laurencebarker/SaturnG2V2_Front_Panel/README.md

# SaturnG2V2_Front_Panel
 V2 andromeda-like panel for G2
