laurencebarker/SaturnG2V2_Front_Panel/documentation/G2 mk2 front panel Notes.docx

# G2 Mk2 Front Panel Implementation Notes

This documentation is for the G2 mk2 front panel PCB using the Arduino Nano Every processor and 2 MCP23S17 ICs. It has I2C interface to the Raspberry Pi.

# 1 Control Layout

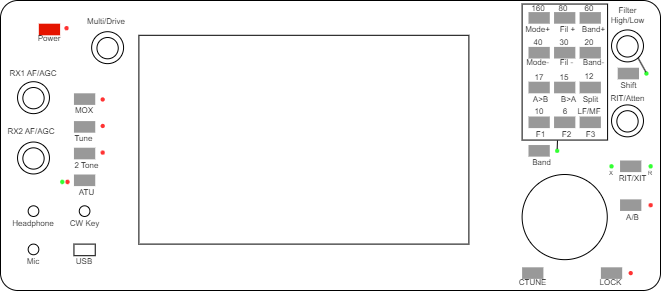
[picture p1: figure]

## 1.1 Encoder Numbers

The VFO encoder is treated differently from the dual encoders because its inputs are processed differently. From a software perspective, each dual encoder can have A (upper) and B (lower) encoders plus a “click” function. The “click” is treated as a pushbutton by the Arduino.

The top right encoder will be able to have two functions, using a “Shift” button. The Shift functionality is implemented in the Arduino, and the Raspberry Pi will see 6 dual connected encoders.

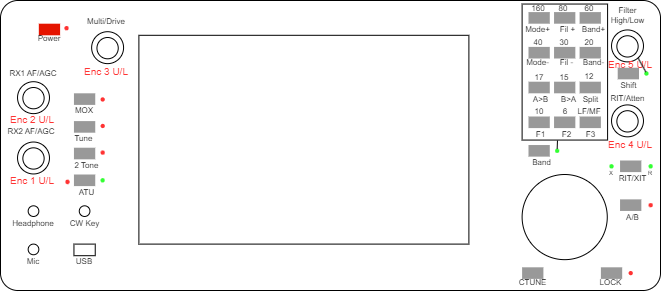
[picture p2: figure]

Figure 1: Encoder numbers

Normal dual shaft encoders have encoder numbers as follows:

Encoder | Software Scan Code
| Upper knob | Lower knob
1 | 0 | 1
2 | 2 | 3
3 | 4 | 5
4 | 6 | 7
5 | 8 | 9
6 (encoder 5 when shift is active) | 10 | 11

(CAT message identify the encoder numbers as scan code + 1)

## 1.2 Pushbutton Numbers

Pushbuttons have two numbers: the software scan code from the matrix algorithm; and the number that is reported to the Raspberry pi. A lookup table from scan code gives the reporting number. The scan codes are only used by the Arduino software and have no user meaning.

Band buttons in the 3x4 matrix have two functions according to the BAND shift. The band shift functionality is implemented in the Arduino; the effect is that the user software “sees” additional pushbuttons for band and unshifted function. If shift pressed, a button code 13 higher is given for example "Fil -" will give a code of 18 (no shift) or 31 (band function shifted). The shift buttons themselves do not send codes to the Raspberry Pi. PB13 (encoder 5 pushbutton) will generate a code of 26 if the encoder shift is selected. If encoder shift is active, the button for encoder 5 will generate a different code of 41.

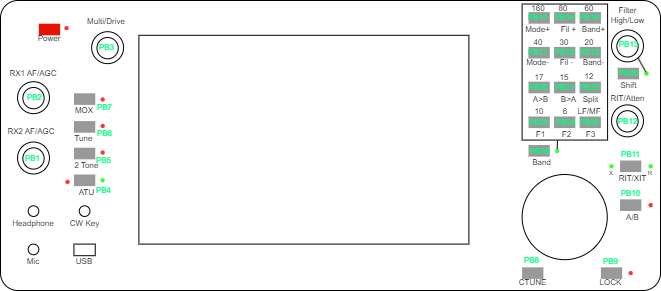
[picture p3: figure]

Figure 2: Software Scan Codes

A complete list of reported button codes is below.

Button Function | Code | Button Function | Code | Button Function | Code | Button Function | Code
No button | 0 | RIT/XIT | 11 | Split | 22 | 17M | 33
Encoder 1 press | 1 | Encoder 4 press | 12 | User 1 | 23 | 15M | 34
Encoder 2 press | 2 | Encoder 5 press | 13 | User 2 | 24 | 12M | 35
Encoder 3 press | 3 | Mode + | 14 | User 3 | 25 | 10M | 36
ATU | 4 | Filter + | 15 | No button | 26 | 6M | 37
2 Tone | 5 | Band + | 16 | 160M | 27 | LF/MF | 38
Tune | 6 | Mode - | 17 | 80M | 28 | Band shift* | 39
MOX | 7 | Filter - | 18 | 60M | 29 | Encoder shift* | 40
CTUNE | 8 | Band - | 19 | 40M | 30 | Shifted Encoder 6 press | 41
LOCK | 9 | A>B | 20 | 30M | 31
A/B | 10 | B>A | 21 | 20M | 32

Band and encoder shift codes are only generated if a command has been sent to disable normal shift processing. This is appropriate for Thetis but not for piHPSDR.

## 1.3 Indicator Numbers

Note LED10, 11 are not accessible to client s/w. Their functions are controlled by the Arduino, unless shift functionality has been disabled by a command.

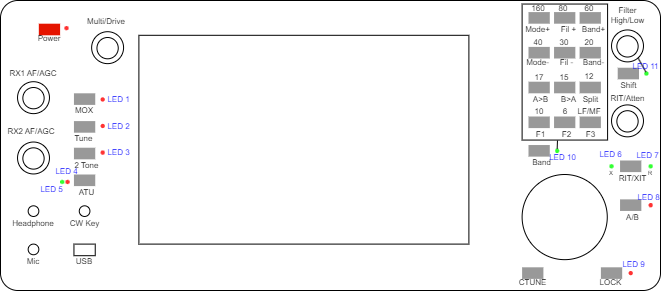
[picture p4: figure]

Figure 3: Indicator Numbers

# 2 Arduino Software Structure

An 8 bit Arduino Nano Every will be used, with software substantially based on the Andromeda panel code.

## 2.1 Concept for Operation

The Arduino will interface the I/O devices, consisting of optical VFO encoder, mechanical dual shaft encoders, pushbuttons and LEDs. It will handle all debouncing and present completed event data to the Raspberry pi. Events will be stored in a simple circular buffer queue and transferred at a timestep of every few milliseconds (potentially every 10ms) to avoid signalling and data transfer becoming a drain on processor resources.

Events will consist of:

- VFO encoder steps (potentially up to 20 steps per 10ms timestep);
- Mechanical encoder steps;
- Pushbutton events.

In addition the Arduino will receive commands at similar rate via serial to set front panel LEDs.

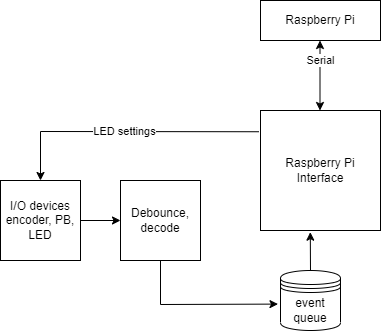
[picture p5: figure]

Figure 4: Software Structure

The VFO encoder may generate 500 steps per revolution and can be turned at 4 revolutions per second; so several steps per timestep are possible. VFO encoders generate clean edges, and interrupt driven operation is viable.

Mechanical encoders generate noisy edges and will be polled, with a debounce period of around 5 - 10ms after detection of a transition. A high turn rate would be one revolution per second and typically 24 steps so typically a rate of 40ms per step. One step per event is sufficient. All encoders will be scanned in parallel, but it is unlikely that more than one will be turned at a time so a high event rate is unlikely.

Pushbutton encoders also generate noisy edges and will be polled. The pushbuttons will be scanned in a matrix, allowing only one button press at a time. A debounce period of ~10ms is required and the event rate will be a max of say two presses per second. Both “normal” and “long” presses will be decoded.

Two “special” pushbuttons will provide a shift function. These will provide additional functions for 12 pushbuttons, and for one dual encoder. This will be decoded by the Arduino and the Raspberry pi will see an interface as if an additional 12 buttons and one additional dual encoder are present. (These two buttons and their LEDs can also be set to operate like other pushbuttons by command message from the Raspberry pi).

## 2.2 Use of Timeslots

Like all of my Arduino projects, the code will work to a fixed timer driven timestep. It will not follow the normal Arduino practice of executing a loop continuously; it will only run a loop once per timestep. That allows real time operation with known event timings.

Follow the principle from the Andromeda front panel controller: 2ms timestep is the starting point.

In one timeslot we need to:

- Do one update of the key matrix (involves SPI read, then SPI write);
- Update half of the encoders; (SPI 16 bit read);
- Update any LEDs;
- Add any events to event queue and assert interrupt if it is not empty;
- Drive new switch matrix column in advance of next tick.

## 2.3 SPI ports

SPI connects to two MCP23S17 devices. Each has an active low chip select input, to be driven by the Arduino. There is no interaction or dependency with the Raspberry Pi interface.

SPI needs to support the following operations:

1. 8 bit register write, for configuration & for LED / matrix column write
2. 16 bit read from adjacent registers (encoder data read)
3. 8 bit read from one register (switch matrix row read)

## 2.4 Data Exchange with Raspberry Pi

Serial message exchanges needed for:

1. Set indicators (ZZZI exists for this)
2. Read product ID, hardware ID, software version (ZZZS)
3. Read VFO encoder steps (ZZZU, ZZZD)
4. Read dual encoder events (ZZZE)
5. Read pushbutton events (ZZZP)

## 2.5 CAT Messages

This unit uses the same CAT commands as used for Andromeda. That means the existing THETIS / piHPSDR CAT command set can be used.

Control type | Command | Meaning
VFO encoder | Up: ZZZUnn; Down: ZZZDnn; | nn = number of clicks (0-99)
Other encoder | ZZZEnnm; | nn = encoder number: 0: unused 1-20: encoder 1-20, clockwise 51-70: encoder 1-20, anticlockwise m=number of clicks (0-9)
Pushbutton (including encoder) | ZZZPnnm; | nn=button number (1-99, 0=n/a); m=0: released; m=1: pressed; m=2: long pressed
Indicator | ZZZInnm; | nn=indicator number (1-99, 0=n/a); m=0: unlit; m=1: lit
Send s/w Version | ZZZS; Response ZZZSppnnmmm; | pp=product id 1: Andromeda 2: Aries 3: Ganymede 4: G2 panel; 5: G2V2 panel nn= hardware version mmm= s/w version

## 2.6 Scan codes

Button, indicator numbers are as indicated in the pictures at the start of the document. They are listed here together with suggested functions for client SDR applications.

### 2.6.1 Encoder

Physical control | s/w code for CAT message | Suggested function
1, upper | 1 | RX2 AF Gain
1, lower | 2 | RX2 AGC
2, upper | 3 | RX1 AF Gain
2, lower | 4 | RX1 AGC
3, upper | 5 | Multifunction encoder
3, lower | 6 | TX drive
4, upper | 7 | RIT/XIT
4, lower | 8 | Attenuation
5, upper (no shift) | 9 | RX filter high cut
5, lower (no shift) | 10 | RX filter low cut
5, upper (SHIFT lit) | 11 | Diversity gain
5, lower (SHIFT lit) | 12 | Diversity phase

### 2.6.2 Pushbutton

Scan code | Marking | Suggested function (normal) | Suggested function (long press)
1 | Encoder 1 press | RX2 Mute
2 | Encoder 2 press | RX1 Mute
3 | Encoder 3 press | Change multifunction assignment
4 | ATU | Not yet used – TBD
5 | 2 Tone | Toggle 2 tone test
6 | Tune | Toggle TUNE
7 | MOX | Toggle MOX
8 | CTUNE | Toggle CTUNE
9 | LOCK | Toggle VFO lock
10 | A/B | Set whether other buttons affect VFO A or VFO B. If not yet pressed, A
11 | RIT/XIT | Toggle between off/RIT/XIT
12 | Encoder 4 press | Clear RIT and XIT
13 | Encoder 5 press (no shift) | Reset variable filter 1
14 | Mode + | Select next mode | Open MODE menu?
15 | Fil + | Select next filter | Open FILTER menu?
16 | Band + | Select next band | Open BAND menu?
17 | Mode - | Select previous mode
18 | Fil - | Select previous filter
19 | Band - | Select previous band
20 | A>B | Copy VFO A to B
21 | B>A | Copy VFO B to A
22 | Split | Toggle SPLIT
23 | F1 (user defined) | Menu selected? | Open menu to set its function?
24 | F2 (user defined) | Menu selected? | Open menu to set its function?
25 | F3 (user defined) | Menu selected? | Open menu to set its function?
26 | (no code generated) | n/a
27 | 160m band | Set band
28 | 80m band | Set band
29 | 60m band | Set band
30 | 40m band | Set band
31 | 30m band | Set band
32 | 20m band | Set band
33 | 17m band | Set band
34 | 15m band | Set band
35 | 12m band | Set band
36 | 10m band | Set band
37 | 6m band | Set band
38 | LF/MF band | Set band
39 | (reserved)
40 | (reserved)
41 | Encoder 2 press (SHIFT lit) | RX Diversity on/off

(remember that a long press will generate the event for a normal press first!)

### 2.6.3 Indicator

Indicators should give an “on/off” indication associated with the control they are paired with.

Indicator | Suggested function | Lit when
1 | MOX | MOX is active
2 | TUNE | TUNE is active
3 | 2 TONE | Puresignal is enabled
4 | ATU Red | Auto Tune is enabled
5 | ATU Green | TBD
6 | XIT | XIT is active for selected/active RX
7 | RIT | RIT is active for selected/active RX
8 | A/B | Lit if VFO A is selected/RX1 is active
9 | LOCK | Lit if selected/active VFO is locked
10 | Band shift | (not controllable remotely)
11 | Encoder shift | (not controllable remotely)

## 2.7 Suggested behaviour between Panel, p2app and SDR Client

### 2.7.1 p2app with Thetis

1. After p2app initialisation, p2app sends ZZZS to get product, sw, hw version
2. p2app displays result on console
3. On CAT connection, p2app sends outgoing ZZZS with that data to Thetis
4. P2app polls CAT messages to Thetis for indicators
  a. p2app decodes response
  b. p2app sends ZZZI for individual changed indicators
5. When p2app receives ZZZU/D/E/P message from the panel:
  a. p2app doesn’t decode the message
  b. p2app sends entire CAT message to TCP/IP port

### 2.7.2 p2app with piHPSDR

1. After p2app initialisation, p2app sends ZZZS to get product, sw, hw version
2. p2app displays result on console
3. On CAT connection, p2app sends outgoing ZZZS with that data to Thetis
4. p2app polls CAT messages to Thetis for indicators
  a. p2app decodes response
  b. p2app sends ZZZI for individual changed indicators
5. When p2app receives ZZZU/D/E/P message from the panel:
  a. p2app doesn’t decode
  b. p2app sends entire CAT message to TCP/IP port
6. piHPSDR already decodes these CAT commands
7. piHPSDR needs to assign different actions for the control layout/scan codes
8. need to resolve CAT over TCP/IP issue with piHPSDR
9. push notification of indicators may work “as is” with ZZZI
  a. Turn off polling if ZZZI identified?

### 2.7.3 Native piHPSDR

1. piHPSDR will need to establish a local serial connection to /dev/ttyACM0
2. piHPSDR sends ZZZS to panel to get product, sw, hw version
3. When piHPSDR receives ZZZU/D/E/P message from the panel:
4. Decode as normal (as it already does for Andromeda)
5. Push notification of ZZZI may/should also work

## 2.8 G2 Panel code

Everything needed exists and just needs to be configured. It becomes almost identical to Andromeda but with different scan codes.

Panel can be tested with serial console connection; doesn’t need p2app initially.

Andromeda Module | Equivalent G2 module | Comment
andromeda_front_panel_nano.ino | g2v2panel.ino | Keep G2 version. Add additional event handlers to event loop and setup
button.cpp, .h | button.cpp, .h | Keep G2 version; change to send CAT
cathandler.cpp, .h | | Import Andromeda code
encoders.cpp, .h | encoders.cpp, .h | Keep G2 version; change to send CAT
iopins.h | iopins.h | Keep G2 version
led.cpp, .h | led.cpp, .h | Keep G2 version; change to receive CAT
mechencoder2.cpp, .h | mechencoder2.cpp, .h | Keep G2 version
opticalencoder.cpp, .h | opticalencoder.cpp, .h | Keep G2 version
tiger.cpp, .h | | Import Andromeda code
types.h | | Moved to globalinclude.h. Not needed.
globalinclude.h | globalinclude.h | Keep G2 version
configdata.cpp, .h | configdata.cpp, .h | Keep G2; but consider remove completely.
| SPIdata.cpp, .h | Keep G2 version
| eventqueue.cpp, .h | delete

# 3 Software Implementation

## 3.1 Arduino Issues

Arduino Nano Every has an 8 bit ATMEGA4809 processor. I need to change some libraries

- EEPROM.h
- Timer – new code will be needed; no known libraries for ‘4809
- You have to install “Arduino Mega AVR Boards” in the Arduino console Boards manager
- Interrupt driven VFO encoder library doesn’t support ‘4809

Interrupt driven code is poor at debouncing. It does work well with bounce-free optical encoders.

Modified ClickEncoder works well for the other “mechanical” encoders. I’m already using modified encoder code, not in a library. Should be simple to change it again to pass 2 bits of data into it, rather than having I/O pin numbers passed to it.

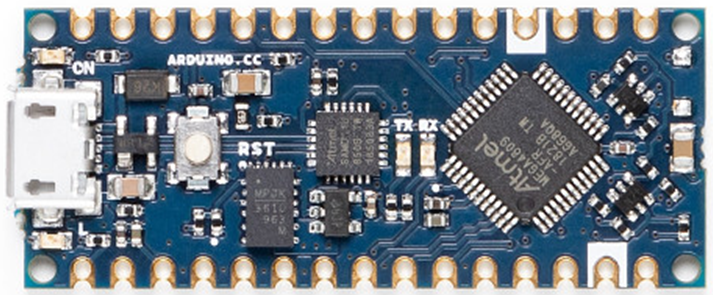
[picture p6: figure]
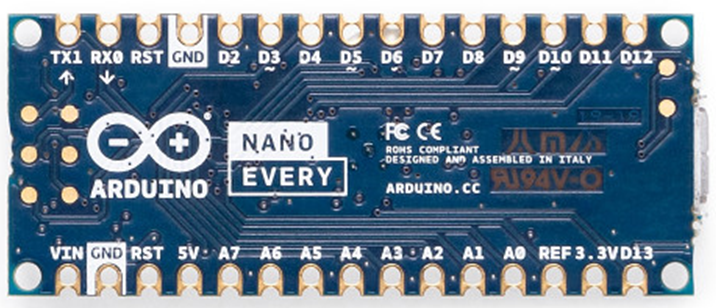
[picture p7: figure]

D12 D11 D10 D9 D8 D7 D6 D5 D4 D3 D2 GND RST D0 D1 D13 3V3 REF A0 A1 A2 A3 A4 A5 A6 A7 5V RST GND VIN

MCP23S17 are 3mA I/O: so not suitable for driving LEDs in a matrix.

The processor is only 8 bit: so change variables wherever possible to be byte (8 bit unsigned) int8_t (signed 8 bit) or int (16 bit) rather than long (32 bit)

The Arduino MUST be powered by 5V. Its internal SMPSU generates a lot of RFI.

## 3.2 Device, Pin Allocations

The front panel I/O entities to be interfaced are:

Interface | Devices | Inputs | Outputs
VFO encoder | 1 | 2
Dual encoder | 5 | 20
Switch/pushbutton | 22 + 5 | 8 | 5
LED | 11 | | 11
SPI Chip selects | | | 2
Interrupt output | | | 1

### 3.2.1 MCP23S17 Pins

MCP23S17 | Number: | 1 | A2=0 A1=0 A0=0
Port A | Encoder inputs | Port B | Encoder inputs
GPA7 | Encoder 1 upper A | GPB7 | Encoder 3 upper A
GPA6 | Encoder 1 upper B | GPB6 | Encoder 3 upper B
GPA5 | Encoder 1 lower A | GPB5 | Encoder 3 lower A
GPA4. | Encoder 1 lower B | GPB4 | Encoder 3 lower B
GPA3 | Encoder 2 upper A | GPB3 | Encoder 4 upper A
GPA2 | Encoder 2 upper B | GPB2 | Encoder 4 upper B
GPA1 | Encoder 2 lower A | GPB1 | Encoder 4 lower A
GPA0 | Encoder 2 lower B | GPB0 | Encoder 4 lower B

MCP23S17 | Number: | 2 | A2=0 A1=0 A0=1
Port A | Switch matrix column/ enc | Port B | Switch Matrix Row INPUT
GPA7 | LED1 | GPB7 | Switch Matrix Row 8
GPA6 | LED2 | GPB6 | Switch Matrix Row 7
GPA5 | LED3 | GPB5 | Switch Matrix Row 6
GPA4 | LED4 | GPB4 | Switch Matrix Row 5
GPA3 | Switch Matrix Column 4 out | GPB3 | Switch Matrix Row 4
GPA2 | Switch Matrix Column 3 out | GPB2 | Switch Matrix Row 3
GPA1 | Switch Matrix Column 2 out | GPB1 | Switch Matrix Row 2
GPA0 | Switch Matrix Column 1 out | GPB0 | Switch Matrix Row 1

### 3.2.2 Arduino Pins

Pin | Arduino | Function | Pin | Arduino | Function
16 | DIG1 / TX | Serial TXD | 29 | DIG11 | SPI Controller Out, Peripheral In
17 | DIG0 / RX | Serial RXD | 30 | DIG12 | SPI Controller In, Peripheral out
20 | DIG2 | Encoder 5 upper A | 1 | DIG13 | SPI Clock
21 | DIG3 | Encoder 5 upper B | 4 | A0 | LED10
21 | DIG4 | Encoder 5 lower A | 5 | A1 | LED11
23 | DIG5 | Encoder 5 lower B | 6 | A2 | MCP23S17A (U1) CS~
24 | DIG6 | LED5 | 7 | A3 | MCP23S17B (U2) CS~
25 | DIG7 | LED6 | 8 | A4 / SDA | VFO encoder A
26 | DIG8 | LED7 | 9 | A5 / SCL | VFO encoder B
27 | DIG9 | LED8 | 10 | A6
28 | DIG10 | LED9 | 11 | A7 | Interrupt to Raspberry pi (no longer used)

(Note Abhi’s schematic shows pin 16 being DIG0/TX; it should say DIG1/TX)

## 3.3 Optical Encoder Scanning

The Broadcom type encoder gives 120 pulses per revolution. By counting every edge, ie 480 edges per revolution, it is good enough for VFO control (4.8KHz per revolution @10Hz step).

The ball bearing encoders are too fast. The 600ppr encoder gives 2400 edges per revolution and when turned at about 1.5 turns per second, the VFO control on Thetis starts to run backwards.

A solution is to have conditional compilation, and for the high resolution optical encoders only interrupt on the rising edge of one input (therefore 600 interrupts per revolution) and use the other input to sense direction.

In globalinclude.h:

To compile for the high resolution encoder:

#define HIRESOPTICALENCODER 1

To compile for the Broadcom type encoder:

//#define HIRESOPTICALENCODER 1

## 3.4 LEDs

LEDs are easy to drive; either connected to a processor pin or to an MCP23S17 register.

See sections 2.1 and 2.2 for LED connections.

## 3.5 Keypad scanning

Pushbuttons are scanned using a 4x8 matrix allowing a possible 32 pushbuttons.

| Column 4 2GPA3 | Column 3 2GPA2 | Column 2 2GPA1 | Column 1 2GPA0
Row 8 2GPB7 | | Band +
Row 7 2GPB6 | | Filter + | | Encoder 3 U/L
Row 6 2GPB5 | Encoder 5 U/L | Band - | Mode + | Encoder 2 U/L
Row 5 2GPB4 | Encoder 4 U/L | Filter - | Mode - | Encoder 1 U/L
Row 4 2GPB3 | Encoder Shift | SPLIT | A>B | MOX
Row 3 2GPB2 | RIT/XIT | B>A | User1 | Tune
Row 2 2GPB1 | A/B | User3 | Band SHIFT | 2 Tone
Row 1 2GPB0 | VFO Lock | USER2 | CTUNE | ATU

Switches have been placed into the matrix so the columns are approximately geographical with column 1 covering the left of the panel and column 4 the right.

Switch scan code is (row number-1) + (Column number-1) *8

I will need to use a simple sequencer to scan the pushbuttons. Don’t attempt to cope with more than one button press. Assert a new column low every software tick, then read the rows and look for a row with one or more bits at zero. Only one row driven low at a time. A “helper” function reads the row input and assigns a row code: 0: no button pressed; 1-8: row 0-7 pressed; FF: more than one pressed.

Columns driven using pseudo open drain outputs from MCP23S17, so if there are shorted columns it doesn’t matter. Outputs only drive a logic 0 level; inactive column outputs are disabled by turning the pins into inputs.

If the same key was pressed for more than 2 seconds, a “long press” is declared in the BUTTON PRESSED state.

Figure 5: Suggested keypad scanning sequencer

## 3.6 Button Handling

if (shift button override)

{

button code looked up from 1st half of table

Send button code

}

else

{

if (Button == band shift)

{

Toggle BandShift;

Update band shift LED;

}

else if (button == encoder shift)

{

Toggle EncoderShift;

Update encoder shift LED;

}

else

{

if(BandShift)

Lookup PB number from 2nd table

else

Lookup PB number from 1st table

Send button code

}

}

## 3.7 Switch Matrix Wiring

(note only 4 columns in this case)

Every row has a pullup resistor. Columns are driven by the MCP23017; one column will be 0, the others will be 1. If no buttons pressed, the Row word reads out all 1s ie 0xFF. An “open drain” output is synthesised by enabling or disabling the output; and the output is always driven to zero. Only one column output will be enabled as an output at a time.

# 4 Testing

## 4.1 Testing in Arduino Alone

Connect USB cable to PC. Open Arduino terminal window. “blink” LED blinks at 1Hz rate | Works OK
LED startup scan, lighting each LED in turn | OK
VFO encoder | c/w and ac/w turns cause events to be displayed in the serial window. Far turns get several steps displayed.
Dual encoders | All encoders give events for c/w and ac/w turn. The “shifted” encoder (top right) can provide two scan codes depending on state of shift. (8&9 or 10&11)
Pushbuttons | All pushbuttons generate “pressed” and “released events. All give the correct scan code. “long press” declared after ~2s press, and this might be better reduced. With button band “shift” pressed we get the alternate scan codes.

## 4.2 Testing with Raspberry Pi

Powers up with no bus conflicts | OK
I2C discovery program can find the Arduino: sudo apt-get install i2c-tools i2cdetect -y 1 | OK; finds correct address
Data can be pushed to Arduino | Can set LEDs
Data can be read from Arduino | Can read panel s/w version, encoder and pushbutton data
Interrupt asserted if data in queue | Yes
Operational data transfer | Interrupt driven code can read I2C and read out and display all events
Serial Data Transfer | Via Serial1; no issues (this code taken from existing Andromeda)

## 4.3 Testing in p2app

P2app retrieves product ID, HW & SW version | OK
LEDs set from CAT polled data | OK
Dual shaft encoder events sent to Thetis | OK
VFO encoder sent to Thetis | OK. ~5KHz per revolution with 10Hz steps (correct)
Shifter encoder seen correct by Thetis | OK
Pushbutton events sent to Thetis | OK
Shifted band pushbuttons sent to Thetis | OK
Reliability with I2C | Periodically there is erroneous i2c data. Data=0x0000: suspect this is where the pi sees an interrupt that didn’t happen? Once per 100 events, and can be ignored. Data=0x0819 (should be something like 1118): this is a bis shift. It is as though one bit didn’t get set. Signal integrity? Pi or Arduino drivers? Less common, but means an event has been missed

# 5 p2app Interface

If the panel is controlled by p2app, then it will need to exchange “CAT over TCPIP” messages with Thetis.

Thetis operates a timeout: if a connection does not exchange data for 30s, it times out and drops the TCP/IP connection. “Keep alive” message exchange works, and a 15s message request means connection is maintained indefinitely.

Encoders and pushbuttons can all push data to Thetis. It will not be practical to have Thetis push data to the panel (there is no longer a specific CAT instance to be used) and the panel will need to use CAT commands to establish the LED state.

s/w number | Function | CAT message
1 | MOX | Combined VFO Status
2 | Tune | Combined VFO Status
3 | 2 Tone | 2 Tone (ZZUT)
4 | ATU Tune solution | (internal to panel)
5 | ATU enabled | (internal to panel)
6 | XIT | Combined VFO Status
7 | RIT | Combined VFO Status
8 | A/B | A/B (ZZYR)
9 | VFO lock | Combined VFO Status
10 | Band shift | (internal to panel)
11 | Encoder shift | (internal to panel)

Message | CAT message detail | Notes
Combined VFO Status | Get: ZZXV; Ans: ZZXVNNNN; NNN = 0 - 1023 | Combines reporting of RIT, LOCK, SPLIT, CTUNE, MOX and TUNE status Bit 0: RIT on/off (see ZZRT) Bit 1: VFO A LOCK status (see ZZUX) Bit 2: VFO B LOCK status (see ZZUY) Bit 3: SPLIT status (see ZZSP) Bit 4: VFO A CTUNE status (see ZZCN) Bit 5: VFO B CTUNE status (see ZZCO) Bit 6: MOX status (see ZZTX) Bit 7: TUNE status (see ZZTU) Bit 8: XIT on/off (see ZZXS) Bit 9: VFO SYNC on/off (see ZZSY)
2 Tone on/off | Get: ZZUT; Ans: ZZUTN; | N=0: off; N=1: 2 tone test active
A/B collapsed display buttons | Get: ZZYR; Ans: ZZYRN; | N=0: RX1; N=1: RX2

# 6 I2C Issues

An original version of this panel used I2C, which did not prove reliable.

## 6.1 Message Transfer to/from Pi

### 6.1.1 I2C Transfers

The Arduino will interrupt the Raspberry pi via a GPIO pin if there is any data in the event queue; the interrupt will be removed when the queue has been emptied (therefore it is level triggered). The raspberry pi will be able to read event data as 16 bit words via I2C; it will read words until the queue is empty. the Arduino will transfer a zero word if there is nothing in the queue. The Raspberry pi will be able to write new LED data at any time. A message queue of 15 words is likely to be sufficient, allowing over 100ms latency in the Raspberry pi.

The pi could also poll the Arduino by reading the I2C port every 10ms or so and taking all messages when it finds data present.

A slave write I2C transfer is a 3 byte sequence: 8 bit address / RW word, 8 bit data low byte, 8 bit data high byte.

A slave read I2C consists of a 1 byte address written to the Arduino, then a 2 byte read (low byte 1st)

Be aware of the clock stretching issues which is an apparent bug in the Raspberry pi (see 6.3). This means the 1st bit transferred back from Arduino to pi on a read can be lost: ie bit 7 of the low byte. A pragmatic “fix” is to avoid using that bit.

### 6.1.2 Message Structure From Arduino

Address | Register bits 15:8 | Register bits 7:0
0x0A | LED Word 15:8 | LED Word 7:0
0x0B | 3:0: Event ID 7:4: queue depth after this read | 7:0 Event data
0x0C | Product ID. 0x03 (G2V2 front panel) (Side effect: clear interrupt out) | SW version
0x0D | 0x00 | HW Version
Other | 0x00 | 0x00

Field | Bits | Meaning
Queue Depth | 4 | Number of events held in the queue (0-15) before this transfer. 0 means no data. A value of 1 will leave no remaining data in the queue after this read.
Event ID | 4 | Event type 0: no event 1: VFO encoder step 2: dual encoder step 3: pushbutton press 4: pushbutton long press 5: pushbutton release 6-15: reserved
Event Data | 8 (bit7=0) | Pushbuttons: scan code for pushbutton (1 to 127) VFO encoder: no. steps (signed 7 bits: -64 to +63) Dual encoder: bits (6:3) = encoder number; 2:0 = step count (-4 to +3)

### 6.1.3 Message Structure to Arduino

Address | Register bits 7:0 | Register bits 15:8
0x0A | LED Word 7:0 | LED Word 15:8
Other | ignored

A simple command word to the Arduino is sufficient.

Bit | 15 | 14 | 13 | 12 | 11 | 10 | 9 | 8 | 7 | 6 | 5 | 4 | 3 | 2 | 1 | 0
Meaning (normal) | PBX | 0 | 0 | 0 | 0 | LED11 | LED10 | LED9 | LED8 | LED7 | LED6 | LED5 | LED4 | LED3 | LED2 | LED1

Field | Meaning
LED(10:0) | Control the state of individual LEDs. 1 if lit. bit0 sets front panel LED1 Note LEDs 10 & 11 are not controlled by this message unless PBX=1
LED(15): PBX | Shift Button Override. If set, the two shift buttons and their LEDs operate like the others i.e. do not control the scan codes generated by other buttons and encoders.

## 6.2 Event Queue

The event queue will be a circular buffer, implemented as an array of 16 bit unsigned ints. A write pointer will indicate where the next write will occur; a read pointer will indicate where the next read will occur. A buffer length of 16 will be sufficient. The current number of entries can be obtained from (W-R) % 16

Row
15 | Initially empty | | After 3 Writes | | After 3 reads | | Later: 3 unread entries; write pointer has wrapped around
14 | | | | | | | | R
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
3 | | | | W | | W, R
2
1 | | | | | | | | W
0 | | W, R | | R

## 6.3 I2C interface

There is an I2C interface to the Raspberry Pi. The Pi is the bus master, and the Arduino responds as a slave at address 0x15. The pi will be able to establish whether the Arduino is present to determine if there is an attached front panel (and to distinguish from the current “controller 2” panel).

I2C uses Arduino pins A4 & A5; pullups are required.

An interrupt pin will be required to signal to the Pi that data is available. This is active low, and open collector (requiring pullup to 3.3V by the pi). Open collector simulated by setting pin to be an output only if int is to be asserted.

I2C needs to support the following operations:

- 16 bit slave read, initiated by the Raspberry pi
  - Arduino returns event 16 bit queue entry, or 0 if no event available
  - Arduino clears the interrupt if the event queue is now empty
- 8 bit slave write, initiated by the Raspberry pi
  - Arduino sets LEDs and one control bit

Two registers will be provided for writing LEDs.

Four registers will be provided for read: to read back the LED registers; read board type and s/w version; and read button/encoder events.

Note that the I2C interface on the prototype connects to the Raspberry pi which has 3.3V logic levels. There are two ways forward:

1. Use level translators between levels;
2. Use direct wired connection, with the (internal to pi) pullups to 3.3V
  a. This means the Arduino gets max input of 3.3V, and VIH is 3.5 so not guaranteed to work).

## 6.4 I2C communication issues

I get occasional failures to transfer a “1” bit on bit 7 of the 1st byte sent back by the Arduino. Maybe 5% of the time.

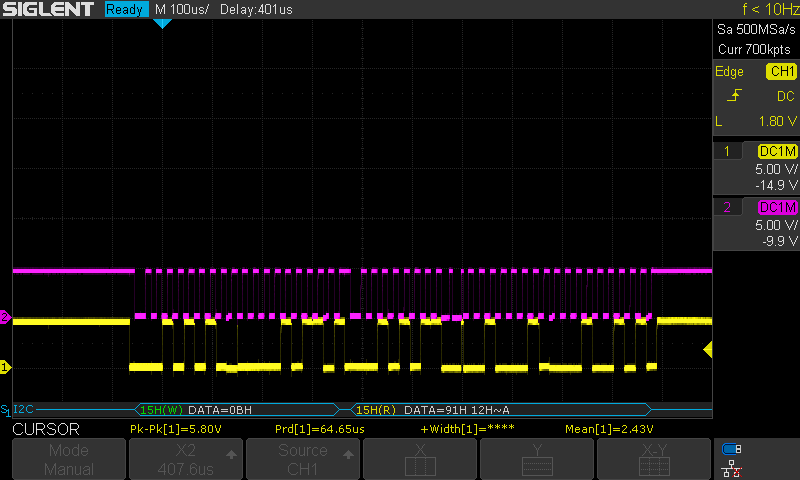
[picture p8: figure]

There seem to be some known issues related to clock stretching:

https://raspberrypi.stackexchange.com/questions/91410/rpi-to-arduino-i2c-block-data-read-fails-with-errno-121-remote-i-o-error-pyt

https://github.com/raspberrypi/linux/issues/4884

https://github.com/raspberrypi/linux/issues/254

The pragmatic thing to do is to edit the message format so that bit is not used.

We persist in getting crashes from the Arduino. No obvious cause.

# 7 Raspberry pi changes

Pin 10 (GPIO18) needs to be freed up:

1. Open a terminal window
2. sudo nano config.txt
3. Find the lines with dtoverlay=gpio-shutdown
4. Change them to read

dtoverlay=gpio-shutdown, gpio_pin=26

gpio=18=op,dh

5. save and close the file
6. reboot

Serial port needs to be enabled:

1. open Preferences > Raspberry pi configuration
2. Select Interfaces tab
3. Enable Serial Port
4. Disable Serial Console
5. Click OK

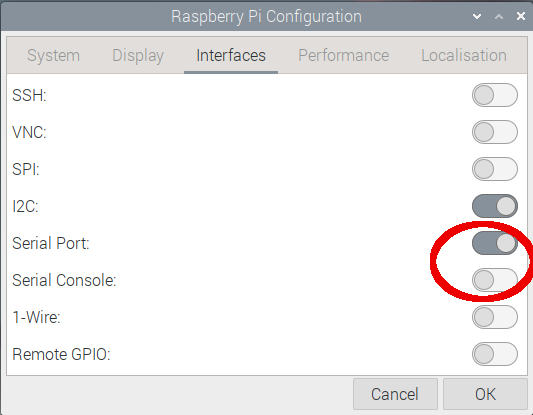
[picture p9: figure]

Test the connection to the panel:

1. Install minicom:
2. sudo apt-get install minicom
3. Type minicom -D /dev/ttys0 -b 9600
4. Type zzzs;
5. You should get a response like ZZZS0502009;

That means all the connectivity is in place.

(Note this configuration of config.txt is specific to the G2V2 panel; The earlier G2 panel needs the original configuration below)

dtoverlay=gpio-shutdown,gpio_pin=26

gpio=15=op,dh

not sure where this should be documented: p2app has support for the original G2 and the G2V2 panel, by autodetection. The G2 panel code can be configured for “original” Thetis (emulating Andromeda) or G2 (emulating a “stripped down” G2 panel). For andromeda emulation, uncomment #defined LEGACYANDROMEDA 1

This should be removed from use once the G2 supported Thetis is readily available.

# 8 Arduino Software Installation

This guide describes how to download, install and load the Arduino software for the Odin console. The guide assumes that you are using the Arduino Integrated Development Environment (IDE) running on a windows platform. For users with different operating systems, different folder locations will probably apply.

## 8.1 Install the Arduino IDE

The Arduino IDE is downloaded from the Arduino web page. The download links are on this page:

https://www.arduino.cc/en/Main/Software

Download and install the IDE. When you run it for the first time, it will look something like:

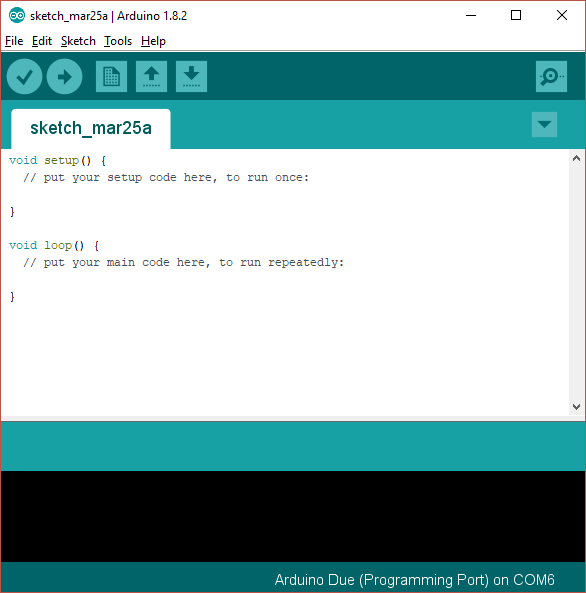
[picture p10: figure]

This is showing you a new, blank program. Arduino programs are called “sketches”.

## 8.2 Add Support for the Nano Every Boards

As shipped the Arduino IDE can build code for some of the processor types used in the Arduino range, but not for the Arduino “Due” used in this project. A simple download will add the Due:

1. Open the Arduino IDE
2. Click “Tools|Board|Boards manager” on the menu
3. Scroll down to the entry for “Arduino Mega AVR boards by Arduino” and click “install”
4. Your screen should look something like this:

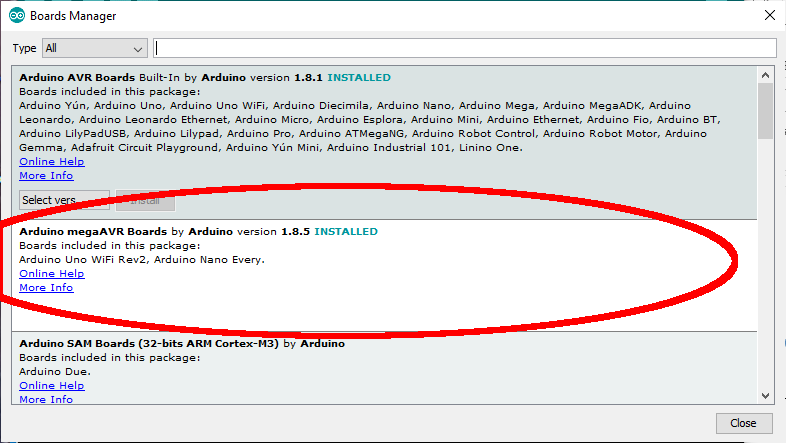
[picture p11: figure]

## 8.3 Download the Panel Software Repository

1. Visit the repository on github: https://github.com/laurencebarker/SaturnG2V2_Front_Panel
2. Click “clone or download” then “download zip”
3. Store the zip file on your PC for example in the “downloads” folder
4. Open the zip file and extract to your PC; for example into a folder “SDR” in “documents”
5. There will be a folder called “Andromeda_front_panel-master” in your “SDR” folder

There are several folders:

documentation | The user guide and this installation guide
g2v2panel | Folder for the Arduino sketch
hardware | h/w design schematics etc
pipaneltest | Testing data

## 8.4 Build the code

To open the appropriate software sketch (the filenames etc are listed in the tables above)

1. Run the Arduino IDE
2. Use the "File|Open..." menu command
3. Open the “g2v2panel” folder
4. Navigate to " g2v2panel.ino" and click "open"
5. you should now see the files listed in tabs above the editor window

You now need to tell the IDE what kind of board it is compiling for, and which serial port to use to connect to it.

1. Connect a USB cable between the Arduino programming port (next to the black power connector) and your PC.
2. It may be necessary to install device drivers at this point – follow any instructions.
  a. Click "board" on the "tools" menu and select “Arduino Nano Every”
3. Select “register emulations” on the “Tools” menu to say “none (ATMEGA4809)”
4. Click “port” on the “tools” menu and choose the Arduino COM port listed (mine is COM6)
5. Click "Verify/compile" on the "sketch" menu to compile
6. (A message “compiling sketch…” will appear. This will take around a minute and should result in a message saying the % of program space used)

Finally you need to upload the code to your Arduino:

- Click "Upload" on the "sketch" menu to upload to the Arduino
- A simple progress bar will show in the bottom window of the IDE, twice - for each of "programming" and "verify"
- When it has successful finished the last message will be "CPU reset"
- (note that an error message avrdude: jtagmkII_initialize(): Cannot locate “flash” and “boot” memories in description is reported for the Arduino Nano Every but this can be ignored)

Your Arduino should now be executing the Andromeda code!
