laurencebarker/SaturnG2V2_Front_Panel/g2v2panel/cathandler.h

/////////////////////////////////////////////////////////////////////////
//
// Saturn G2 front panel controller sketch by Laurence Barker G8NJJ
// this sketch provides a knob and switch interface through USB serial
// copyright (c) Laurence Barker G8NJJ 2023
//
// the code is written for an Arduino Nano Every module
//
// CAT handler.h
// this file holds the CAT handling code
/////////////////////////////////////////////////////////////////////////
#ifndef __cathandler_h
#define __cathandler_h
#include <Arduino.h>
#include "tiger.h"



//
// generate output messages for local control events
//
void CATHandleVFOEncoder(signed char Clicks);

void CATHandleEncoder(byte Encoder, char Clicks);

void CATHandlePushbutton(byte Button, bool IsPressed, bool IsLongPressed);




//
// handlers for received CAT commands
//
void HandleCATCommandNumParam(ECATCommands MatchedCAT, int ParsedParam);
void HandleCATCommandNoParam(ECATCommands MatchedCAT);


#endif //not defined
