laurencebarker/SaturnG2V2_Front_Panel/pipaneltest/i2cdriver.c

/* Copyright (C)
* 2024 - Laurence Barker G8NJJ
*
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
*/
#include <string.h>
#include <unistd.h>
#include <errno.h>
#include <stdio.h>
#include <stdlib.h>
#include <linux/i2c-dev.h>
#include <i2c/smbus.h>
#include <sys/ioctl.h>
#include <fcntl.h>
#include <stdint.h>

#include "i2cdriver.h"
extern int i2c_fd;                                  // file reference


//
// 8 bit write
//
int i2c_write_byte_data(uint8_t reg, uint8_t data) 
{
  int rc;

  if ((rc = i2c_smbus_write_byte_data(i2c_fd, reg, data & 0xFF)) < 0) 
  {
    printf("%s: write i2c failed: addr=%02X\n", __FUNCTION__, reg);
  }

  return rc;
}

//
// 16 bit write
//
int i2c_write_word_data(uint8_t reg, uint16_t data)
{
  int rc;

  if ((rc = i2c_smbus_write_word_data(i2c_fd, reg, data & 0xFFFF)) < 0) 
  {
    printf("%s: 16 bit write i2c failed: addr=%02X\n", __FUNCTION__, reg);
  }

  return rc;
}



//
// 8 bit read
//
uint8_t i2c_read_byte_data(uint8_t reg, bool *error) 
{
  int32_t data;

  *error = false;
  data = i2c_smbus_read_byte_data(i2c_fd, reg);
  if(data < 0)
  {
    *error = true;
    printf("error on i2c byte read, code=%d\n", data);
  }
  return (uint8_t) (data & 0xFF);
}


//
// 16 bit read 
//
uint16_t i2c_read_word_data(uint8_t reg, bool *error) 
{
  int32_t data;


  *error = false;
  data = i2c_smbus_read_word_data(i2c_fd, reg);
  if(data < 0)
  {
    *error = true;
    printf("error on i2c word read, code=%d\n", data);
  }
  return (uint16_t) (data & 0xFFFF);
}
