laurencebarker/SaturnG2V2_Front_Panel/(commit log)

2024-01-04 hardware drivers and I2C complete
2024-06-03 updated after initial testing on h/w
    device drivers work. LED selftest added. I2C not yet tested.
2024-06-06 updated I2C tx/rx code
2024-06-08 communication with pi established and LED writes OK
2024-06-09 updated code: I2C transferring is correct. Interrupt not checked yet.
    [eventqueue.cpp, globalinclude.h, i2ctest.c]
2024-06-10 updated test to show interrupt status
2024-06-23 updated interrupt to totem pole drive, for level shifter. "smile" LED test.
2024-06-23 added newest i2ctest and re-added debug
2024-07-02 bug fixes
    added error detection to i2ctest, to detect timed out transaction
    removed code in Arduino interrupt handler that turn interrupts back on (essentially straightlining the code to send data back to i2c)
    [eventqueue.cpp, i2cdriver.c, i2cdriver.h, i2ctest.c]
2024-07-04 updates to get interrupt working on pi
    still getting a bit dropped occasionally: bit 7 of 16 bit transfer sometimes 0
2024-07-06 fixed LS word bit 7 issue
    least significant word transferred back to Raspberry pi by a read often has bit 7=0. This seems to a know "clock stretch" issue with the pi. transfer protocol changed so that bit is always zero.
    see https://github.com/raspberrypi/linux/issues/4884
    [encoders.cpp, g2v2panel.ino, globalinclude.h]
2024-07-07 added LED testing
2024-07-20 tweaked i2c interrupt handler
    Now more reliable: haven't see the "hang"
2024-07-30 moved VFO encoder to A4/A5; serial not I2C
2024-08-11 arduino I/O pin table updated
